oh7bf/RaspiPwr12V/raspipwr12V.png

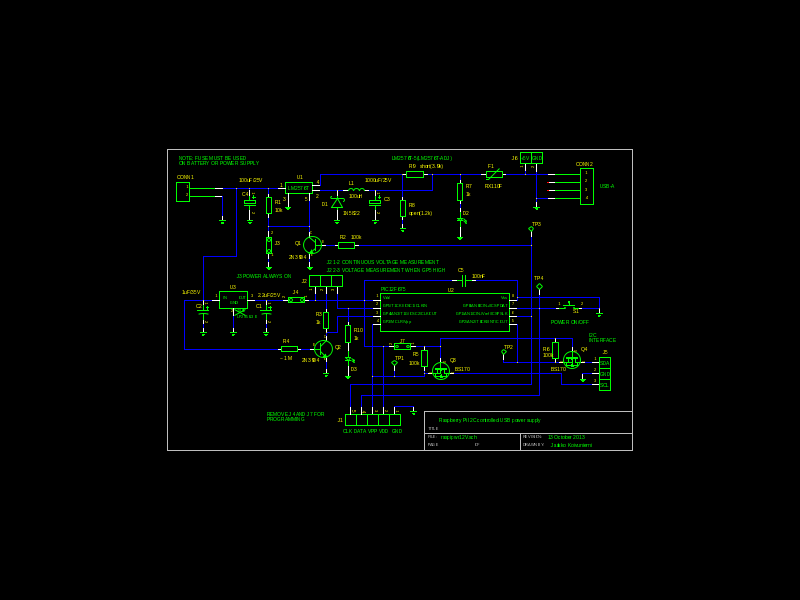
raspipwr12V.png
