oh7bf/RaspiPwr12V/board_component.pdf

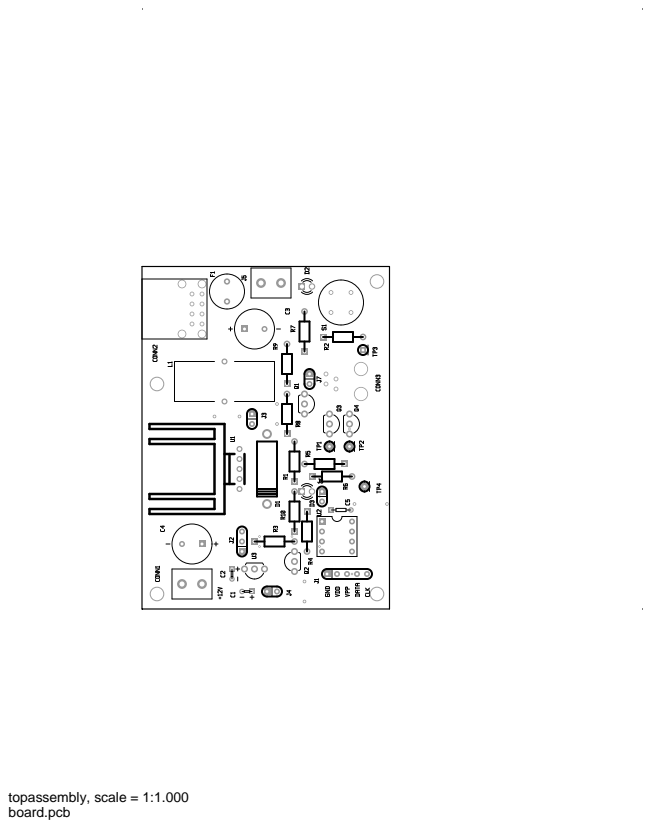
[picture p2: page 1]
board.pcb; topassembly, scale = 1:1.000
