oh7bf/RaspiPwr12V/board_mirror.pdf

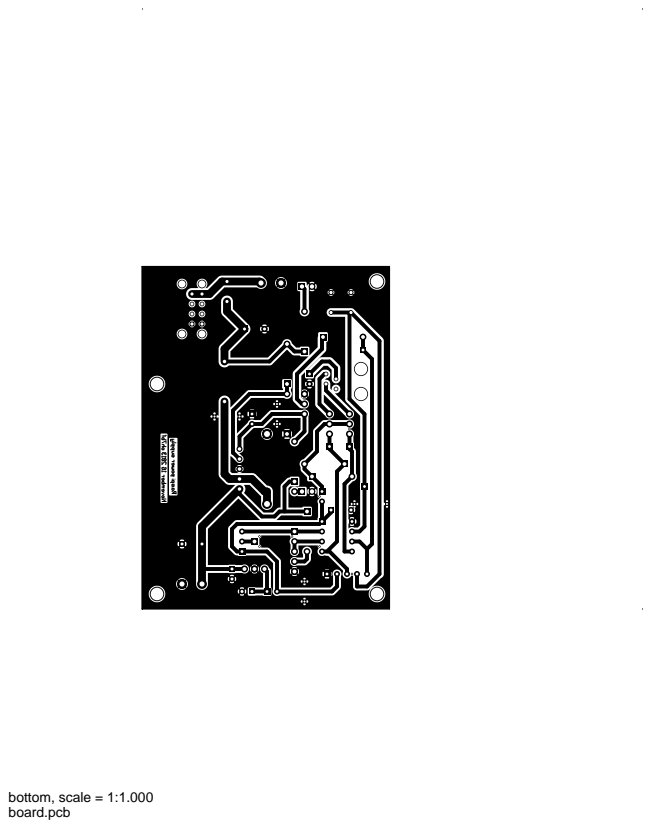
[picture p3: page 1]
board.pcb; bottom, scale = 1:1.000
