oh7bf/RaspiPwr12V/board_silk_mirror.pdf

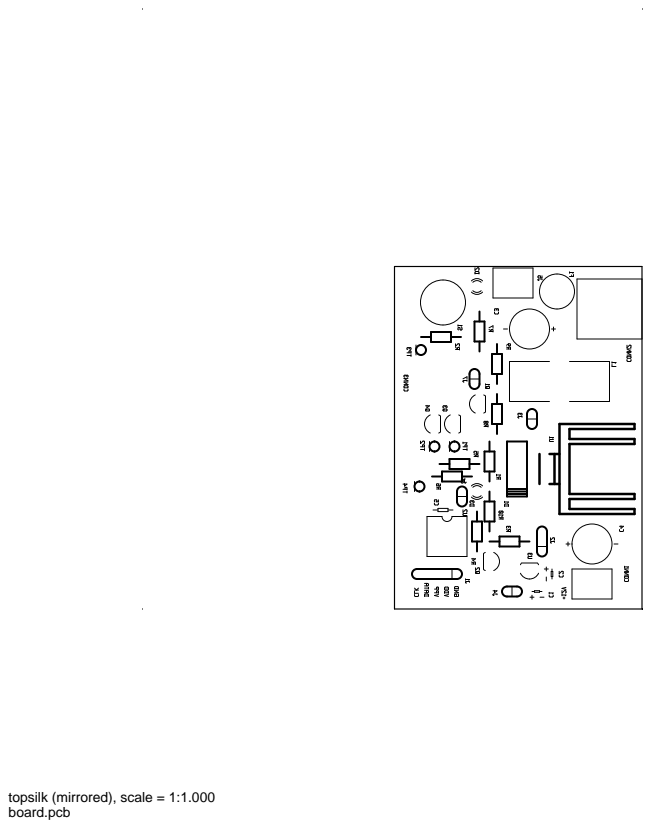
[picture p4: page 1]

topsilk (mirrored), scale = 1:1.000
board.pcb
