oh7bf/RaspiPwr12V/raspipwr12V.pdf

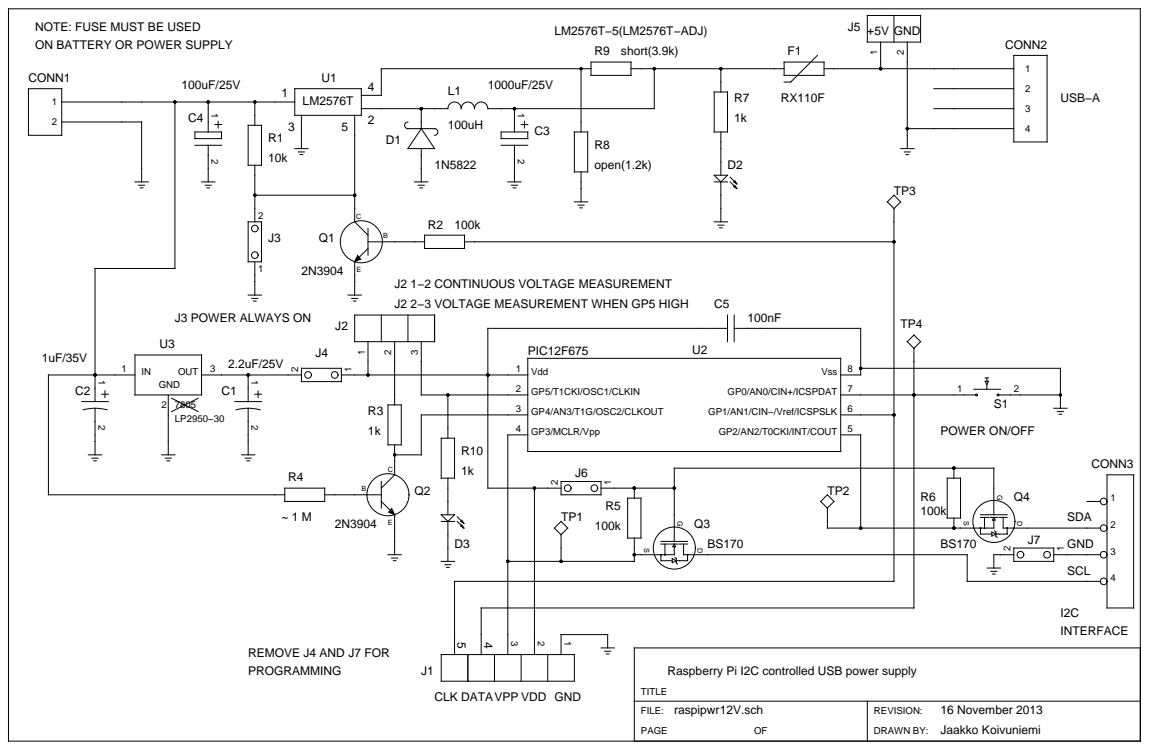
[picture p5: page 1]

NOTE: FUSE MUST BE USED
ON BATTERY OR POWER SUPPLY

J2 1−2 CONTINUOUS VOLTAGE MEASUREMENT
J2 2−3 VOLTAGE MEASUREMENT WHEN GP5 HIGH

Raspberry Pi I2C controlled USB power supply
