oh7bf/RaspiPwr12V/(commit log)

2013-09-11 First version of the circuit diagram.
    [raspipwr12V.sch]
2013-09-15 Add MOSFET to SDA and CLK lines for better protection and level shift.
    Separate GND connection for the I2C since the voltage drop in the USB cable
    could introduce some voltage shift to SDA and SCL.
    Note that Vpp is connected to GP2 with 20 kohm resistance in this circuit.
    [raspipwr12V.sch]
2013-09-16 Add PCB for toner transfer production, BOM and programming information.
    [raspipwr12V.sch]
2013-09-22 Add LED to PIC GP5. Can be used to show active timing command.
    [raspipwr12V.sch]
2013-09-28 New one sided PCB for toner transfer production at home.
    Second version of PCB includes level shifting FETs on the I2C lines. These are
    needed because PIC is operating from 3 V regulator while Raspi is using 3.3 V.
    A second LED was added on PIC GP5. This can used to show active sleep mode
    of the power supply.
    Holes to three ground jumper wires have been added.
    Update circuit diagram.
    [raspipwr12V.sch]
2013-09-29 R5 and R6 100k to reduce current flowing to Raspi powered down.
    Add optional C5 100nF.
    [raspipwr12V.sch]
2013-10-13 Add polyfuse to the power supply output.
    [raspipwr12V.sch]
2013-11-17 Start using modular 4P4C connector for i2c.
    The pins are as follows:
    1 3V3
    2 SDA
    3 GND
    4 SCL
    [raspipwr12V.sch]
2013-11-17 Update README file.
    [raspipwr12V.sch]
2013-11-17 Update PCB files for modular 4P4C connector.
    Output fuse now on the same PCB.
2016-07-31 Add assembly manual for revision 1 PCB
    The manual I2c5VPSUAssembly.pdf tells what components are needed and how
    to assemble the power supply on PCB. Basic instructions on using the
    power converter with Raspberry Pi are given.
